engineerdiaa/cyber-badge/images/parts.jpg

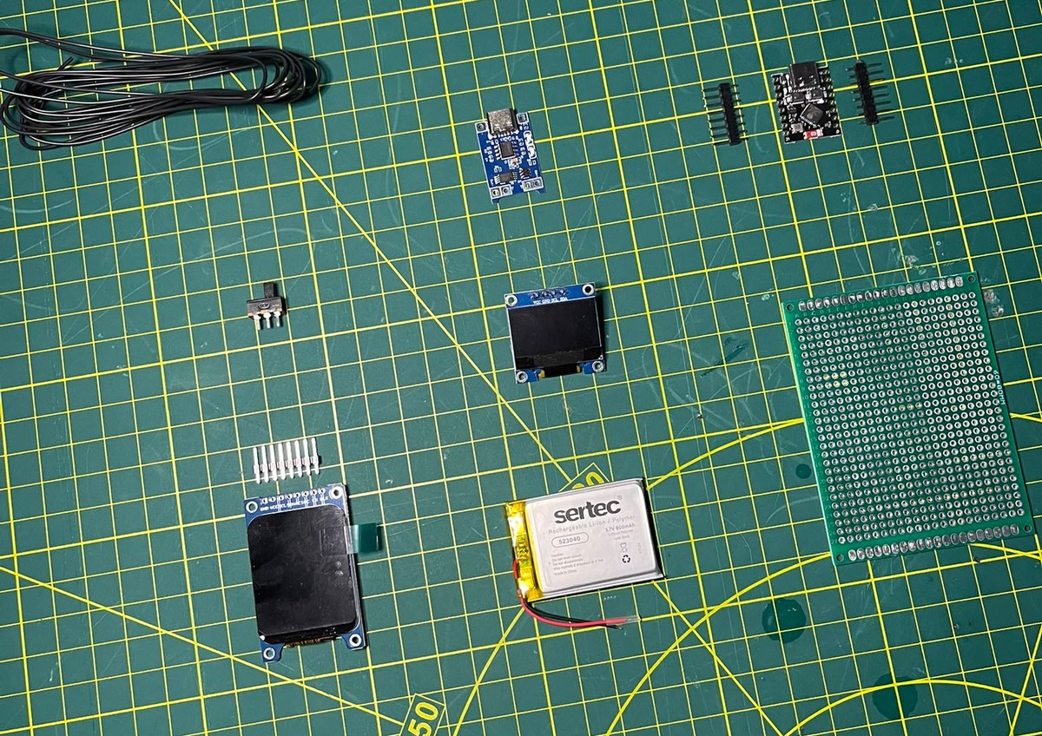
images/parts.jpg
