engineerdiaa/cyber-badge/schematic/cyber_badge.pdf

## Cyber ID Card: schematic

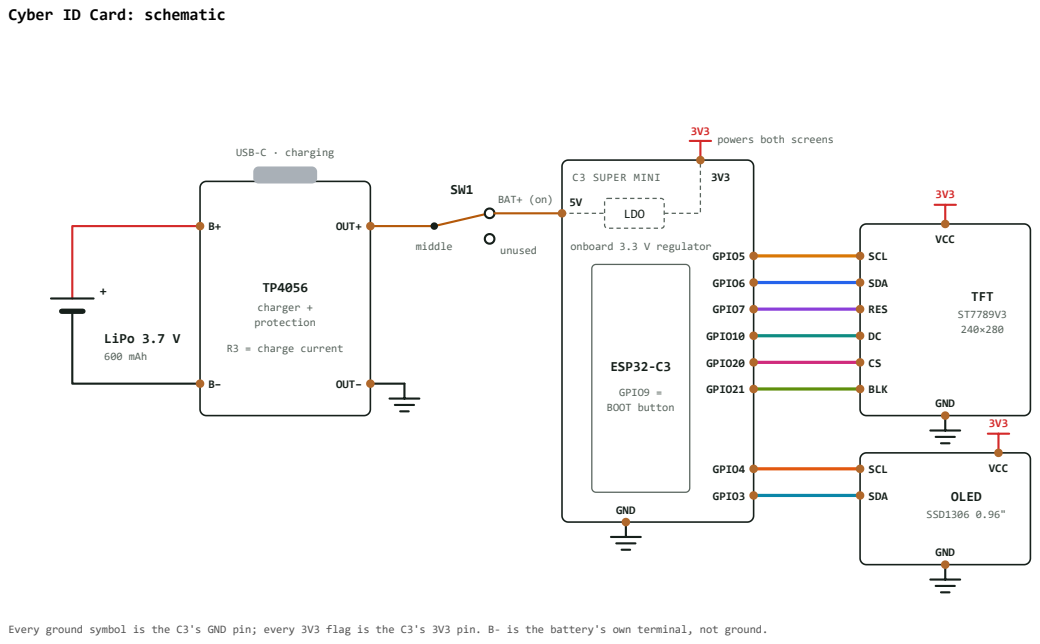
[picture p8: page 1]
LiPo 3.7 V; 600 mAh; USB-C · charging; OUT+; OUT−; charger + protection; R3 = charge current; middle; unused; BAT+ (on); C3 SUPER MINI; LDO; onboard 3.3 V regulator; ESP32-C3; GPIO9 = BOOT button; GPIO5; GPIO6; GPIO7; GPIO10; GPIO20; GPIO21; GPIO4; GPIO3; GND; SCL; SDA; RES; BLK; VCC; TFT; OLED; SSD1306 0.96"

powers both screens

Every ground symbol is the C3's GND pin; every 3V3 flag is the C3's 3V3 pin. B- is the battery's own terminal, not ground.
