engineerdiaa/cyber-badge/(commit log)

2026-10-25 Cyber ID card: firmware, video tools, schematic and build guide
    An ESP32-C3 Super Mini ID card: a 1.69" ST7789 TFT loops a video from
    flash (DMA, 16 fps), a 0.96" SSD1306 OLED shows a name tag with a
    scrolling handle, and a LiPo with a TP4056 charger powers it.
    - firmware/CyberID: sketch with TODO placeholders and a placeholder clip
    - tools: make_video.py (crop, retime, labels, orbit and sticker effects)
    and make_masks.py (rembg cut-outs)
    - Schematic (PDF + SVG), wiring diagrams and reference photos
    - README build guide, CLAUDE.md and Claude Code skills
    - Licenses: MIT (firmware), CERN-OHL-P-2.0 (hardware), CC BY 4.0 (docs)
2026-10-25 Add finished-card teaser, part outlines, any-shape video support
    - README opens with a loop of the finished card (6 s, cropped in on the
    card from the edited clip, animated WebP)
    - Wiring photo: color-coded outlines around the TFT, OLED and ESP32-C3
    pins
    - make_video.py scales frames to cover the panel, so tall, wide and square
    clips all work. SCENE_CROP slides along whichever side has room, and
    labels can be skipped per scene or turned off
    - README, CLAUDE.md and the add-video skill: any video works, the
    three-scene setup is only the example
    - Remove the card mock now that there's a real teaser
2026-10-25 Add a to-scale front view of the board, retitle the teaser
    - images/board_layout_front.svg: the real 80 x 60 mm board drawn to scale
    from the teaser footage. Both headers on top, the C3 chip side up with
    its USB-C on the right, headers snapped to the 2.54 mm grid, in the
    same colors as the back-of-board photo
    - Board layout section: describe the C3's orientation and how the cable
    plugs in from the side
    - Teaser caption now says "Working card preview" (the USB cable is
    still plugged in)
2026-10-25 Align the board layout drawing
    The OLED now sits level with the TFT (both headers on row B) with one
    empty hole column between them, and the C3 lines up under the OLED with
    one empty row between, so no outlines touch. C3 details follow the real
    board, and the BOOT/RST labels no longer hide under the buttons.
2026-10-27 Rename the project to Cyber Badge
    The repo was renamed from cyber-id-card to cyber-badge. This updates every
    reference to match:
    - Title and wording: "Cyber ID Card" / "ID card" / "the card" -> Cyber Badge /
    badge (README, CLAUDE.md, skills, tool comments)
    - Sketch folder and file: firmware/CyberID/CyberID.ino ->
    firmware/CyberBadge/CyberBadge.ino (Arduino needs the names to match)
    - Schematic files: schematic/cyber_id_card.{pdf,svg} -> cyber_badge.{pdf,svg},
    and the PDF's title metadata
    - Skill: flash-card -> flash-badge
    - tools/make_video.py output path and .gitattributes pattern
    - Preferences namespace "cyberid" -> "cyberbadge" (only stores the last clip
    picked with BOOT, so an e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
